nikkiDEEE/search-and-rescue-robot/Alex/Alex/Alex.ino

#include <serialize.h>

#include "packet.h"
#include "constants.h"

/*
 * Alex's configuration constants
 */

// Number of ticks per revolution from the 
// wheel encoder.

#define COUNTS_PER_REV      1

// Wheel circumference in cm.
// We will use this to calculate forward/backward distance traveled 
// by taking revs * WHEEL_CIRC

#define WHEEL_CIRC          1

// Motor control pins. You need to adjust these till
// Alex moves in the correct direction
#define LF                  6   // Left forward pin
#define LR                  5   // Left reverse pin
#define RF                  10  // Right forward pin
#define RR                  11  // Right reverse pin

/*
 *    Alex's State Variables
 */

// Store the ticks from Alex's left and
// right encoders.
volatile unsigned long leftTicks; 
volatile unsigned long rightTicks;

// Store the revolutions on Alex's left
// and right wheels
volatile unsigned long leftRevs;
volatile unsigned long rightRevs;

// Forward and backward distance traveled
volatile unsigned long forwardDist;
volatile unsigned long reverseDist;


/*
 * 
 * Alex Communication Routines.
 * 
 */
 
TResult readPacket(TPacket *packet)
{
    // Reads in data from the serial port and
    // deserializes it.Returns deserialized
    // data in "packet".
    
    char buffer[PACKET_SIZE];
    int len;

    len = readSerial(buffer);

    if(len == 0)
      return PACKET_INCOMPLETE;
    else
      return deserialize(buffer, len, packet);
    
}

void sendStatus()
{
  // Implement code to send back a packet containing key
  // information like leftTicks, rightTicks, leftRevs, rightRevs
  // forwardDist and reverseDist
  // Use the params array to store this information, and set the
  // packetType and command files accordingly, then use sendResponse
  // to send out the packet. See sendMessage on how to use sendResponse.
  //
}

void sendMessage(const char *message)
{
  // Sends text messages back to the Pi. Useful
  // for debugging.
  
  TPacket messagePacket;
  messagePacket.packetType=PACKET_TYPE_MESSAGE;
  strncpy(messagePacket.data, message, MAX_STR_LEN);
  sendResponse(&messagePacket);
}

void sendBadPacket()
{
  // Tell the Pi that it sent us a packet with a bad
  // magic number.
  
  TPacket badPacket;
  badPacket.packetType = PACKET_TYPE_ERROR;
  badPacket.command = RESP_BAD_PACKET;
  sendResponse(&badPacket);
  
}

void sendBadChecksum()
{
  // Tell the Pi that it sent us a packet with a bad
  // checksum.
  
  TPacket badChecksum;
  badChecksum.packetType = PACKET_TYPE_ERROR;
  badChecksum.command = RESP_BAD_CHECKSUM;
  sendResponse(&badChecksum);  
}

void sendBadCommand()
{
  // Tell the Pi that we don't understand its
  // command sent to us.
  
  TPacket badCommand;
  badCommand.packetType=PACKET_TYPE_ERROR;
  badCommand.command=RESP_BAD_COMMAND;
  sendResponse(&badCommand);

}

void sendBadResponse()
{
  TPacket badResponse;
  badResponse.packetType = PACKET_TYPE_ERROR;
  badResponse.command = RESP_BAD_RESPONSE;
  sendResponse(&badResponse);
}

void sendOK()
{
  TPacket okPacket;
  okPacket.packetType = PACKET_TYPE_RESPONSE;
  okPacket.command = RESP_OK;
  sendResponse(&okPacket);  
}

void sendResponse(TPacket *packet)
{
  // Takes a packet, serializes it then sends it out
  // over the serial port.
  char buffer[PACKET_SIZE];
  int len;

  len = serialize(buffer, packet, sizeof(TPacket));
  writeSerial(buffer, len);
}


/*
 * Setup and start codes for external interrupts and 
 * pullup resistors.
 * 
 */
// Enable pull up resistors on pins 2 and 3
void enablePullups()
{
  // Use bare-metal to enable the pull-up resistors on pins
  // 2 and 3. These are pins PD2 and PD3 respectively.
  // We set bits 2 and 3 in DDRD to 0 to make them inputs. 
  
}

// Functions to be called by INT0 and INT1 ISRs.
void leftISR()
{
  leftTicks++;
  Serial.print("LEFT: ");
  Serial.println(leftTicks);
}

void rightISR()
{
  rightTicks++;
  Serial.print("RIGHT: ");
  Serial.println(rightTicks);
}

// Set up the external interrupt pins INT0 and INT1
// for falling edge triggered. Use bare-metal.
void setupEINT()
{
  // Use bare-metal to configure pins 2 and 3 to be
  // falling edge triggered. Remember to enable
  // the INT0 and INT1 interrupts.
}

// Implement the external interrupt ISRs below.
// INT0 ISR should call leftISR while INT1 ISR
// should call rightISR.




// Implement INT0 and INT1 ISRs above.

/*
 * Setup and start codes for serial communications
 * 
 */
// Set up the serial connection. For now we are using 
// Arduino Wiring, you will replace this later
// with bare-metal code.
void setupSerial()
{
  // To replace later with bare-metal.
  Serial.begin(9600);
}

// Start the serial connection. For now we are using
// Arduino wiring and this function is empty. We will
// replace this later with bare-metal code.

void startSerial()
{
  // Empty for now. To be replaced with bare-metal code
  // later on.
  
}

// Read the serial port. Returns the read character in
// ch if available. Also returns TRUE if ch is valid. 
// This will be replaced later with bare-metal code.

int readSerial(char *buffer)
{

  int count=0;

  while(Serial.available())
    buffer[count++] = Serial.read();

  return count;
}

// Write to the serial port. Replaced later with
// bare-metal code

void writeSerial(const char *buffer, int len)
{
  Serial.write(buffer, len);
}

/*
 * Alex's motor drivers.
 * 
 */

// Set up Alex's motors. Right now this is empty, but
// later you will replace it with code to set up the PWMs
// to drive the motors.
void setupMotors()
{
  /* Our motor set up is:  
   *    A1IN - Pin 5, PD5, OC0B
   *    A2IN - Pin 6, PD6, OC0A
   *    B1IN - Pin 10, PB2, OC1B
   *    B2In - pIN 11, PB3, OC2A
   */
}

// Start the PWM for Alex's motors.
// We will implement this later. For now it is
// blank.
void startMotors()
{
  
}

// Convert percentages to PWM values
int pwmVal(float speed)
{
  if(speed < 0.0)
    speed = 0;

  if(speed > 100.0)
    speed = 100.0;

  return (int) ((speed / 100.0) * 255.0);
}

// Move Alex forward "dist" cm at speed "speed".
// "speed" is expressed as a percentage. E.g. 50 is
// move forward at half speed.
// Specifying a distance of 0 means Alex will
// continue moving forward indefinitely.
void forward(float dist, float speed)
{
  int val = pwmVal(speed);

  // For now we will ignore dist and move
  // forward indefinitely. We will fix this
  // in Week 9.

  // LF = Left forward pin, LR = Left reverse pin
  // RF = Right forward pin, RR = Right reverse pin
  // This will be replaced later with bare-metal code.
  
  analogWrite(LF, val);
  analogWrite(RF, val);
  analogWrite(LR,0);
  analogWrite(RR, 0);
}

// Reverse Alex "dist" cm at speed "speed".
// "speed" is expressed as a percentage. E.g. 50 is
// reverse at half speed.
// Specifying a distance of 0 means Alex will
// continue reversing indefinitely.
void reverse(float dist, float speed)
{

  int val = pwmVal(speed);

  // For now we will ignore dist and 
  // reverse indefinitely. We will fix this
  // in Week 9.

  // LF = Left forward pin, LR = Left reverse pin
  // RF = Right forward pin, RR = Right reverse pin
  // This will be replaced later with bare-metal code.
  analogWrite(LR, val);
  analogWrite(RR, val);
  analogWrite(LF, 0);
  analogWrite(RF, 0);
}

// Turn Alex left "ang" degrees at speed "speed".
// "speed" is expressed as a percentage. E.g. 50 is
// turn left at half speed.
// Specifying an angle of 0 degrees will cause Alex to
// turn left indefinitely.
void left(float ang, float speed)
{
  int val = pwmVal(speed);

  // For now we will ignore ang. We will fix this in Week 9.
  // We will also replace this code with bare-metal later.
  // To turn left we reverse the left wheel and move
  // the right wheel forward.
  analogWrite(LR, val);
  analogWrite(RF, val);
  analogWrite(LF, 0);
  analogWrite(RR, 0);
}

// Turn Alex right "ang" degrees at speed "speed".
// "speed" is expressed as a percentage. E.g. 50 is
// turn left at half speed.
// Specifying an angle of 0 degrees will cause Alex to
// turn right indefinitely.
void right(float ang, float speed)
{
  int val = pwmVal(speed);

  // For now we will ignore ang. We will fix this in Week 9.
  // We will also replace this code with bare-metal later.
  // To turn right we reverse the right wheel and move
  // the left wheel forward.
  analogWrite(RR, val);
  analogWrite(LF, val);
  analogWrite(LR, 0);
  analogWrite(RF, 0);
}

// Stop Alex. To replace with bare-metal code later.
void stop()
{
  analogWrite(LF, 0);
  analogWrite(LR, 0);
  analogWrite(RF, 0);
  analogWrite(RR, 0);
}

/*
 * Alex's setup and run codes
 * 
 */

// Clears all our counters
void clearCounters()
{
  leftTicks=0;
  rightTicks=0;
  leftRevs=0;
  rightRevs=0;
  forwardDist=0;
  reverseDist=0; 
}

// Clears one particular counter
void clearOneCounter(int which)
{
  switch(which)
  {
    case 0:
      clearCounters();
      break;

    case 1:
      leftTicks=0;
      break;

    case 2:
      rightTicks=0;
      break;

    case 3:
      leftRevs=0;
      break;

    case 4:
      rightRevs=0;
      break;

    case 5:
      forwardDist=0;
      break;

    case 6:
      reverseDist=0;
      break;
  }
}
// Intialize Vincet's internal states

void initializeState()
{
  clearCounters();
}

void handleCommand(TPacket *command)
{
  switch(command->command)
  {
    // For movement commands, param[0] = distance, param[1] = speed.
    case COMMAND_FORWARD:
        sendOK();
        forward((float) command->params[0], (float) command->params[1]);
      break;

    /*
     * Implement code for other commands here.
     * 
     */
        
    default:
      sendBadCommand();
  }
}

void waitForHello()
{
  int exit=0;

  while(!exit)
  {
    TPacket hello;
    TResult result;
    
    do
    {
      result = readPacket(&hello);
    } while (result == PACKET_INCOMPLETE);

    if(result == PACKET_OK)
    {
      if(hello.packetType == PACKET_TYPE_HELLO)
      {
     

        sendOK();
        exit=1;
      }
      else
        sendBadResponse();
    }
    else
      if(result == PACKET_BAD)
      {
        sendBadPacket();
      }
      else
        if(result == PACKET_CHECKSUM_BAD)
          sendBadChecksum();
  } // !exit
}

void setup() {
  // put your setup code here, to run once:

  cli();
  setupEINT();
  setupSerial();
  startSerial();
  setupMotors();
  startMotors();
  enablePullups();
  initializeState();
  sei();
}

void handlePacket(TPacket *packet)
{
  switch(packet->packetType)
  {
    case PACKET_TYPE_COMMAND:
      handleCommand(packet);
      break;

    case PACKET_TYPE_RESPONSE:
      break;

    case PACKET_TYPE_ERROR:
      break;

    case PACKET_TYPE_MESSAGE:
      break;

    case PACKET_TYPE_HELLO:
      break;
  }
}

void loop() {

// Uncomment the code below for Step 2 of Activity 3 in Week 8 Studio 2

// forward(0, 100);

// Uncomment the code below for Week 9 Studio 2

/*
 // put your main code here, to run repeatedly:
  TPacket recvPacket; // This holds commands from the Pi

  TResult result = readPacket(&recvPacket);
  
  if(result == PACKET_OK)
    handlePacket(&recvPacket);
  else
    if(result == PACKET_BAD)
    {
      sendBadPacket();
    }
    else
      if(result == PACKET_CHECKSUM_BAD)
      {
        sendBadChecksum();
      } 
      
      */
}
